fedejoe123/Control_Rotor/images/IMG_20260402_135818938.jpg

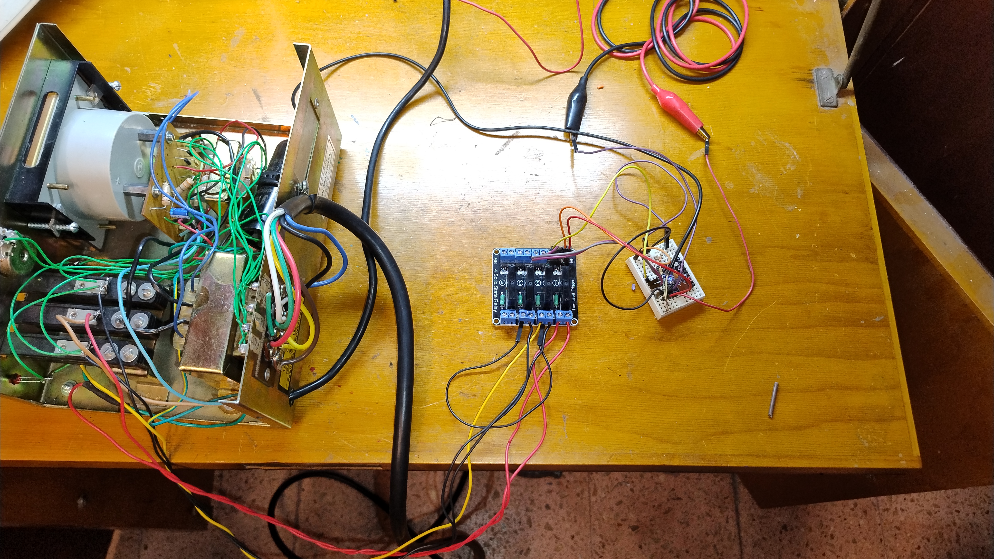
images/IMG_20260402_135818938.jpg
