fedejoe123/Control_Rotor/images/IMG_20260402_141212920.jpg

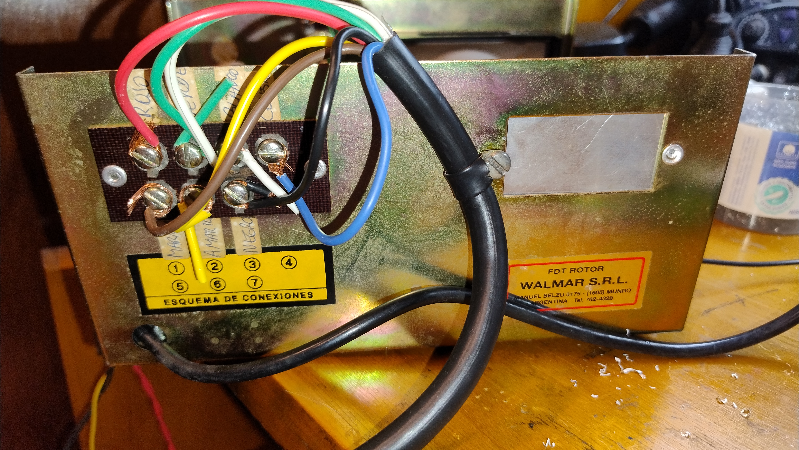
images/IMG_20260402_141212920.jpg
