fedejoe123/Control_Rotor/images/IMG_20260402_151520873.jpg

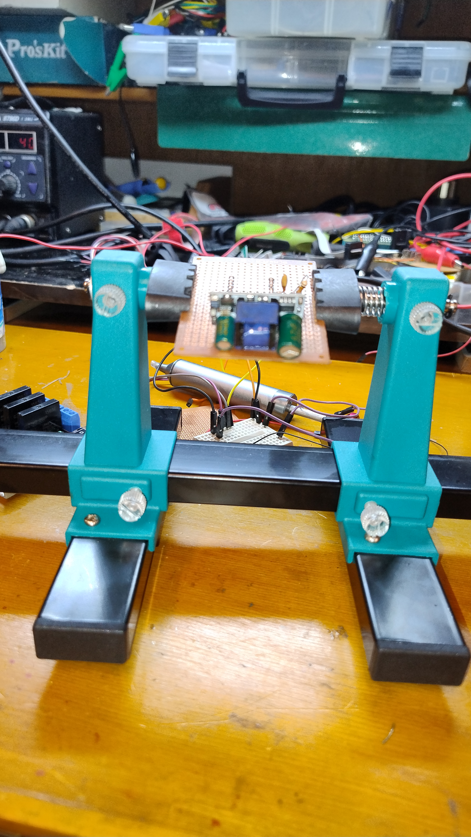
images/IMG_20260402_151520873.jpg
