fedejoe123/Control_Rotor/images/IMG_20260402_173200321.jpg

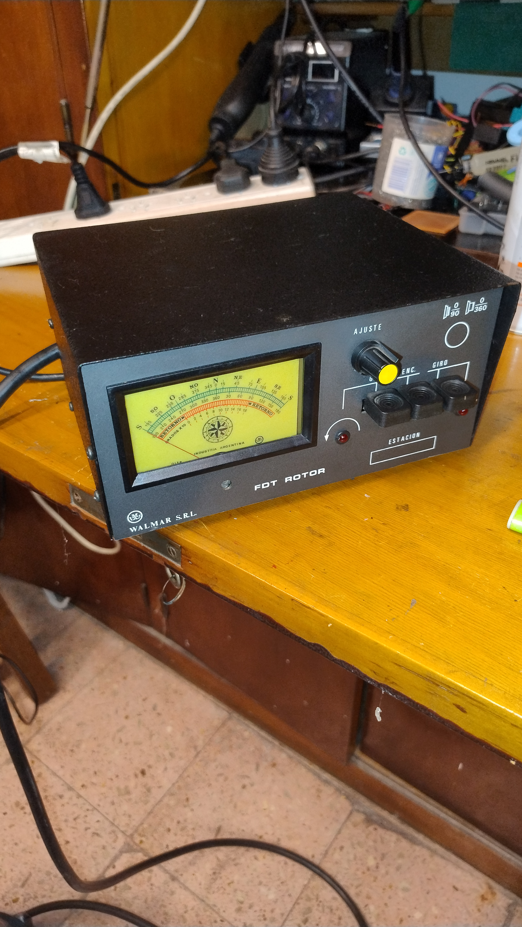
images/IMG_20260402_173200321.jpg
