fedejoe123/Control_Rotor/images/IMG_20260402_173206418.jpg

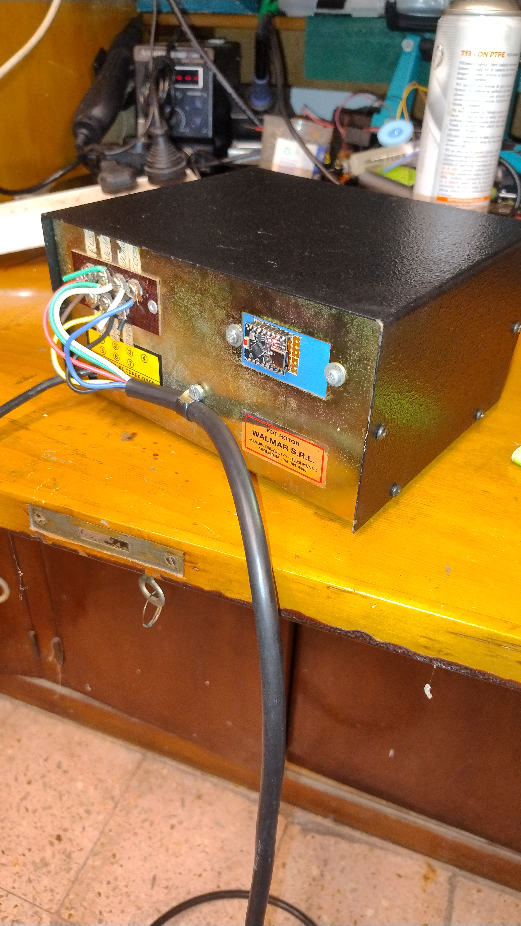
images/IMG_20260402_173206418.jpg
