fedejoe123/Control_Rotor/index_html.h

#ifndef INDEX_HTML_H
#define INDEX_HTML_H

#include <Arduino.h>

#define INDEX_HTML_LEN 20188

const uint8_t INDEX_HTML_GZ[] PROGMEM = {
  0x1F, 0x8B, 0x08, 0x08, 0x66, 0xDF, 0xCD, 0x69, 0x00, 0x03, 0x69, 0x6E, 0x64, 0x65, 0x78, 0x5F,
  0x70, 0x72, 0x65, 0x76, 0x69, 0x65, 0x77, 0x5F, 0x6D, 0x6F, 0x64, 0x2E, 0x68, 0x74, 0x6D, 0x6C,
  0x00, 0xD4, 0x3D, 0xDB, 0x72, 0xDB, 0x48, 0x76, 0xEF, 0xFE, 0x0A, 0x0C, 0x5D, 0xB3, 0xB6, 0xC6,
  0x82, 0x0C, 0x82, 0x17, 0x51, 0x94, 0xA5, 0x2C, 0x45, 0xD1, 0x36, 0x37, 0x22, 0xA9, 0x91, 0xE8,
  0x91, 0xA5, 0x54, 0x1E, 0x40, 0xA0, 0x49, 0xC2, 0x02, 0x01, 0x06, 0x00, 0x49, 0x49, 0x53, 0x4E,
  0x4D, 0x5E, 0xF2, 0x03, 0xD9, 0x4A, 0xE5, 0x75, 0xDF, 0xF3, 0x90, 0xAA, 0x54, 0xE5, 0x21, 0x8F,
  0x99, 0x3F, 0x99, 0x2F, 0xC9, 0xE9, 0x1B, 0xD0, 0x00, 0x1A, 0xE0, 0xC5, 0xF6, 0x6C, 0x32, 0xB3,
  0x1A, 0x09, 0x8D, 0x46, 0x9F, 0xD3, 0xE7, 0xDE, 0xA7, 0x4F, 0xF7, 0xBE, 0xF9, 0xEE, 0x7C, 0xD0,
  0x1E, 0xDE, 0x5E, 0x76, 0x94, 0x69, 0x38, 0x73, 0x4E, 0x9F, 0xBD, 0xC1, 0xBF, 0x14, 0xC7, 0x70,
  0x27, 0x27, 0x25, 0x14, 0x94, 0x70, 0x03, 0x32, 0x2C, 0xF8, 0x35, 0x43, 0xA1, 0xA1, 0x98, 0x53,
  0xC3, 0x0F, 0x50, 0x78, 0x52, 0xFA, 0x30, 0x7C, 0xAB, 0x36, 0x4A, 0xBC, 0xD9, 0x35, 0x66, 0xE8,
  0xA4, 0xB4, 0xB4, 0xD1, 0x6A, 0xEE, 0xF9, 0x61, 0x49, 0x31, 0x3D, 0x37, 0x44, 0x2E, 0x74, 0x5B,
  0xD9, 0x56, 0x38, 0x3D, 0xB1, 0xD0, 0xD2, 0x36, 0x91, 0x4A, 0x1E, 0xF6, 0x15, 0xDB, 0xB5, 0x43,
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
  0x7A, 0xE8, 0x3D, 0x56, 0xCB, 0x5D, 0x80, 0x03, 0x30, 0x75, 0x80, 0x55, 0xC5, 0xB0, 0x01, 0x5E,
  0x31, 0xAC, 0xB7, 0xE6, 0xA6, 0xB0, 0x1E, 0xD9, 0xB8, 0xDA, 0x05, 0x9D, 0xC7, 0x04, 0x78, 0x03,
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
};

#endif // INDEX_HTML_H
