fedejoe123/Control_Rotor/(commit log)

2026-04-02 Revise README for ESP32-C3 Rotor Control Project
    Updated the README to provide detailed information about the ESP32-C3 rotor control project, including features, hardware requirements, installation steps, usage instructions, and API documentation.
2026-04-02 Rename firmware file to rotor_controller.ino
2026-04-07 Revise ESP32-C3 wiring details in README
    Updated wiring diagram for ESP32-C3 and rotor console.
