fedejoe123/Control_Rotor/images/IMG_20260402_135759120.jpg

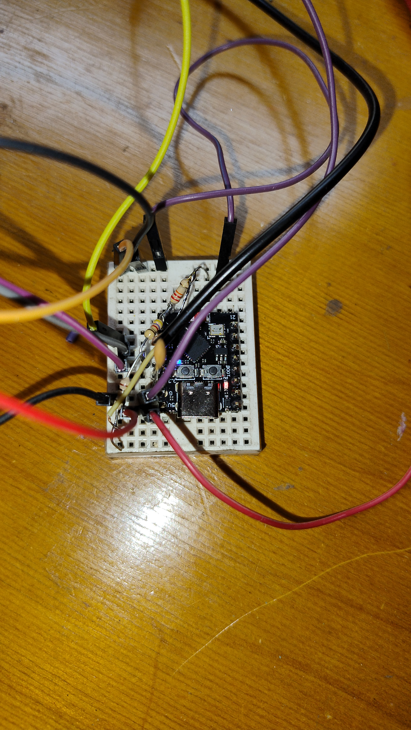
images/IMG_20260402_135759120.jpg
