fedejoe123/Control_Rotor/images/IMG_20260402_135806746.jpg

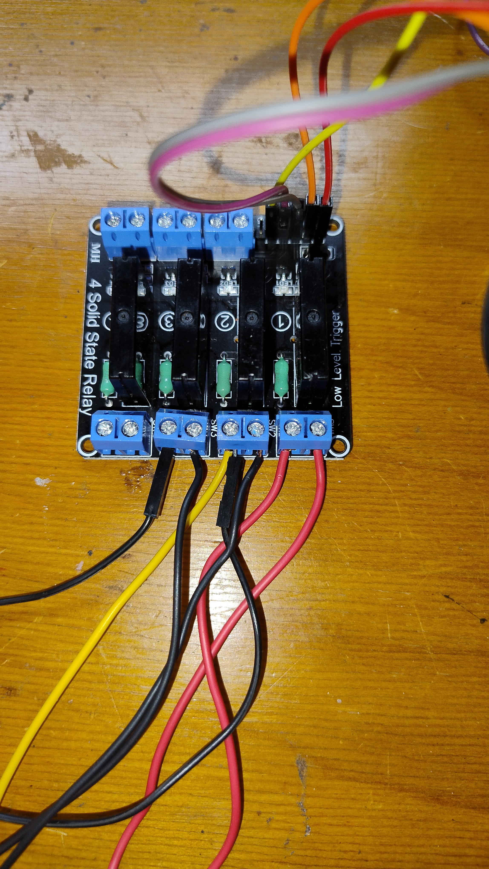
images/IMG_20260402_135806746.jpg
