fedejoe123/Control_Rotor/images/IMG_20260402_135811743.jpg

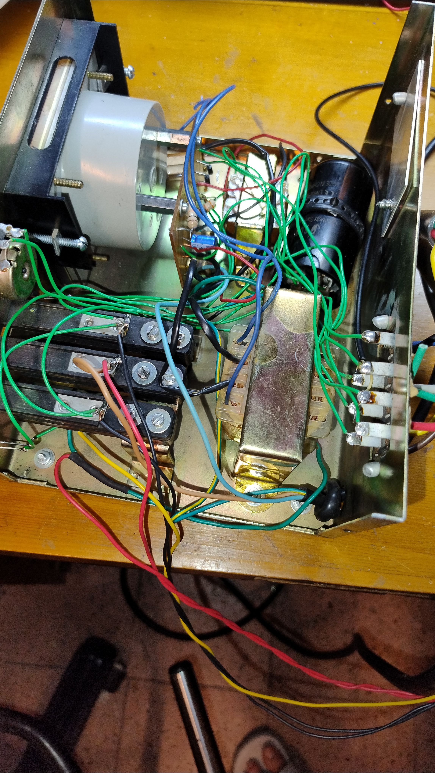
images/IMG_20260402_135811743.jpg
