fedejoe123/Control_Rotor/images/IMG_20260402_140802652.jpg

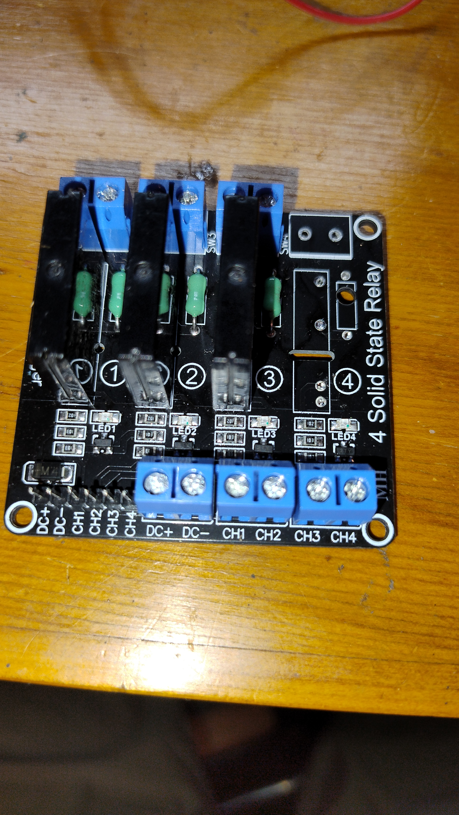
images/IMG_20260402_140802652.jpg
