fedejoe123/Control_Rotor/images/IMG_20260402_141206421.jpg

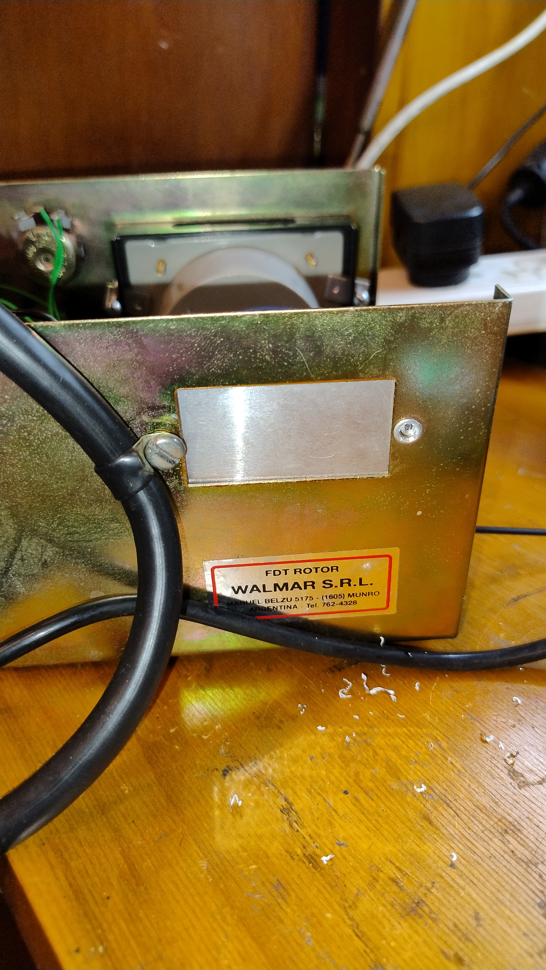
images/IMG_20260402_141206421.jpg
