fedejoe123/Control_Rotor/images/IMG_20260402_145155088.jpg

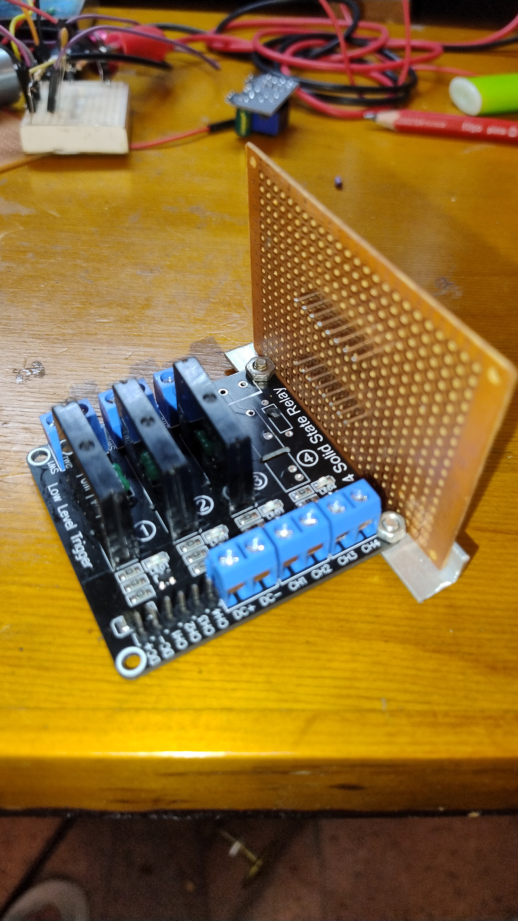
images/IMG_20260402_145155088.jpg
