fedejoe123/Control_Rotor/images/IMG_20260402_145200008.jpg

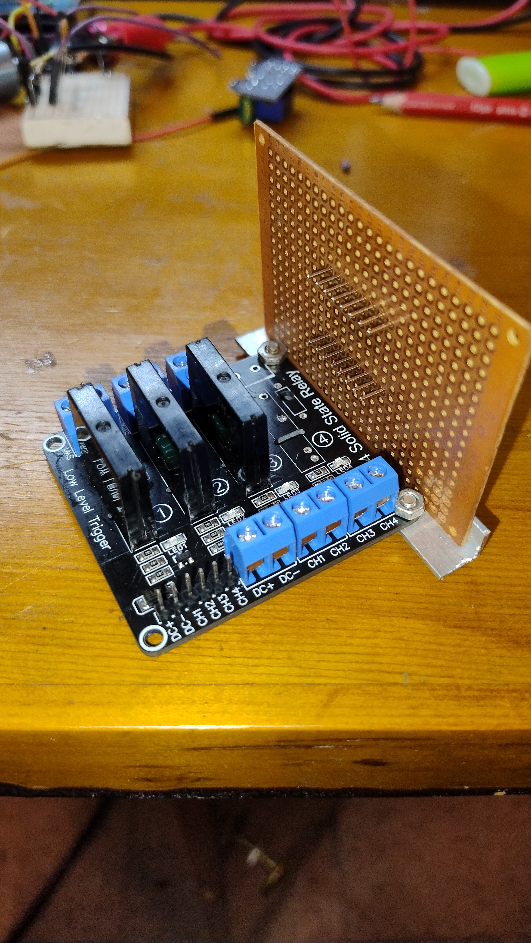
images/IMG_20260402_145200008.jpg
