fedejoe123/Control_Rotor/images/IMG_20260402_145206341.jpg

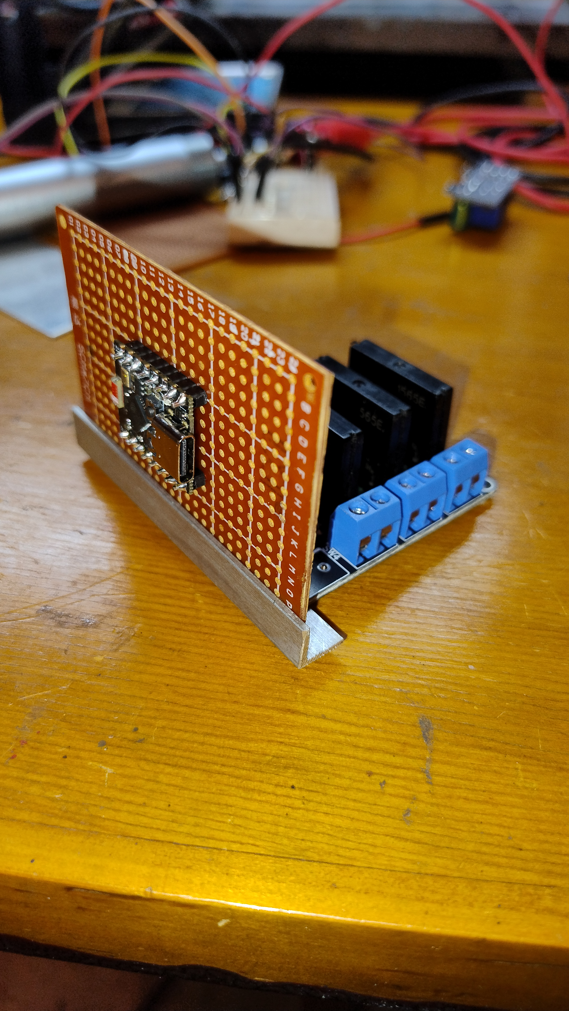
images/IMG_20260402_145206341.jpg
