fedejoe123/Control_Rotor/images/IMG_20260402_145210537.jpg

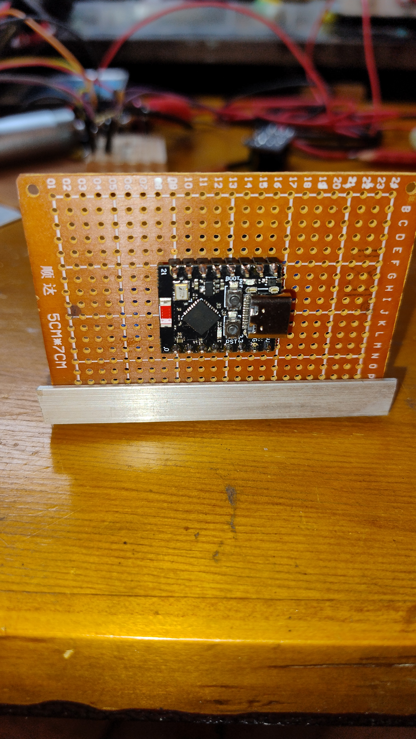
images/IMG_20260402_145210537.jpg
