fedejoe123/Control_Rotor/images/IMG_20260402_145641962.jpg

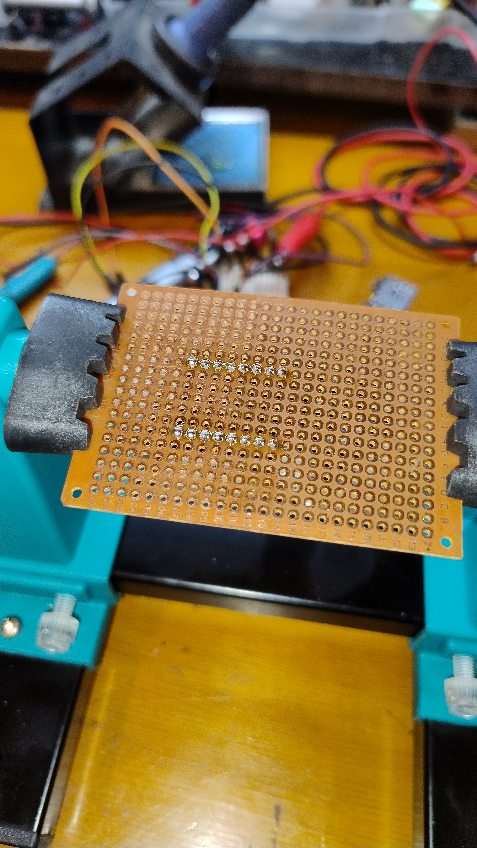
images/IMG_20260402_145641962.jpg
