fedejoe123/Control_Rotor/images/IMG_20260402_145646831.jpg

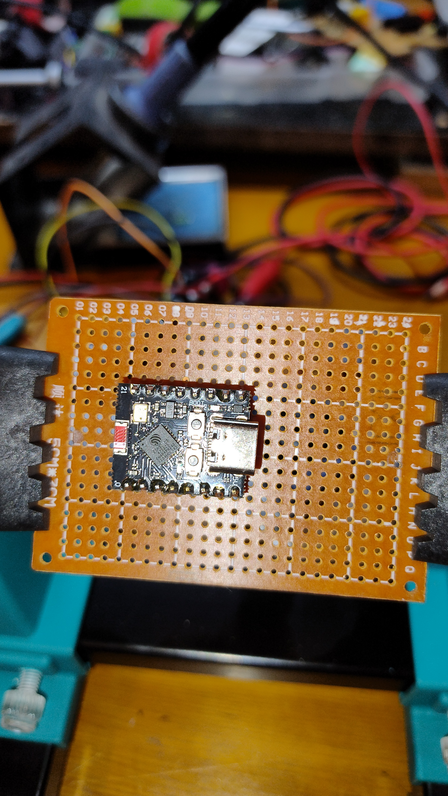
images/IMG_20260402_145646831.jpg
