fedejoe123/Control_Rotor/images/IMG_20260402_151517481.jpg

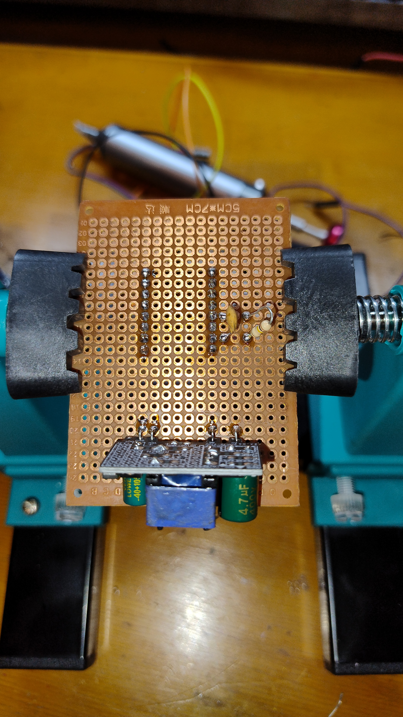
images/IMG_20260402_151517481.jpg
