fedejoe123/Control_Rotor/images/IMG_20260402_155451399.jpg

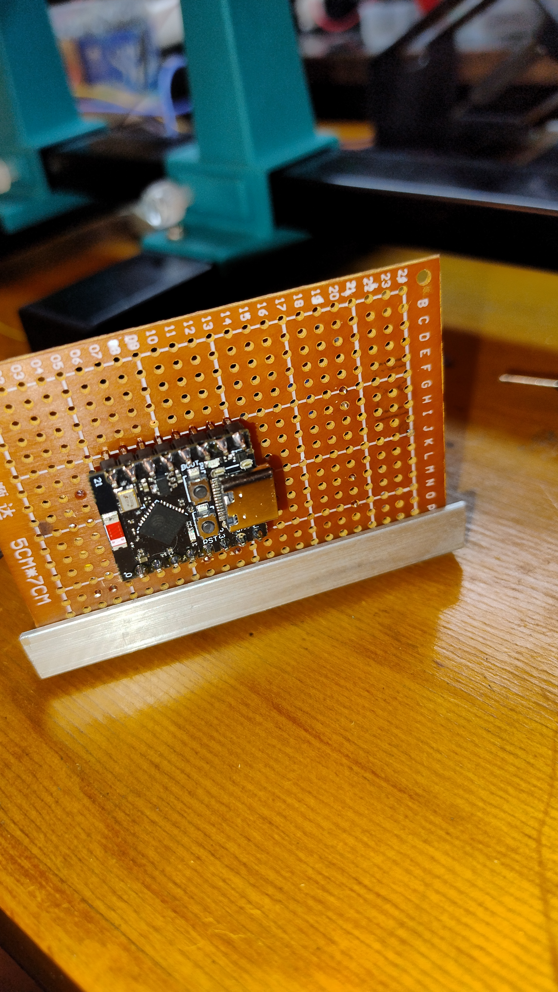
images/IMG_20260402_155451399.jpg
