fedejoe123/Control_Rotor/images/IMG_20260402_162926100.jpg

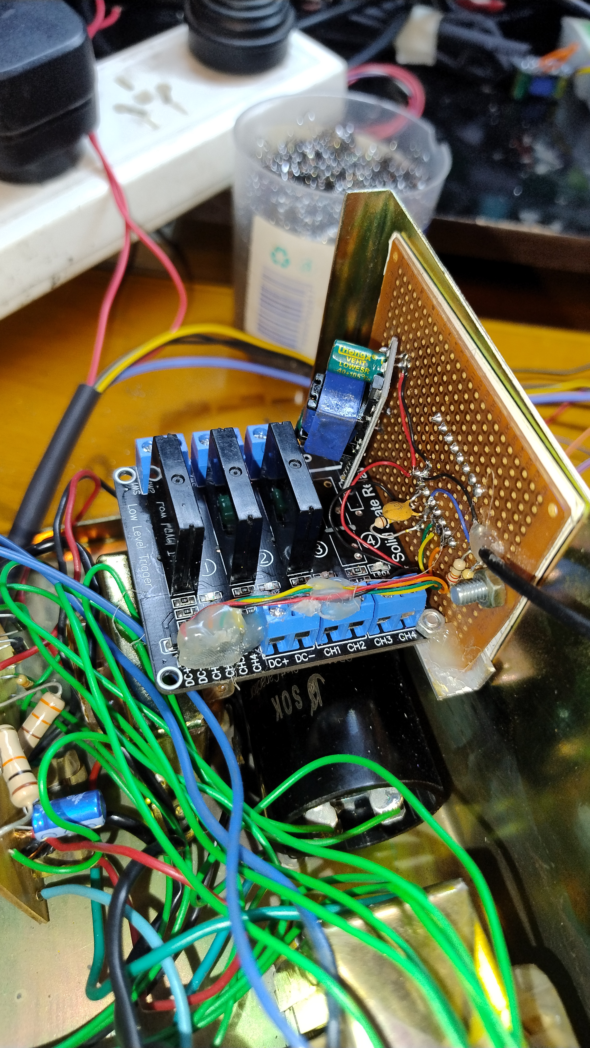
images/IMG_20260402_162926100.jpg
