fedejoe123/Control_Rotor/images/IMG_20260402_162933220.jpg

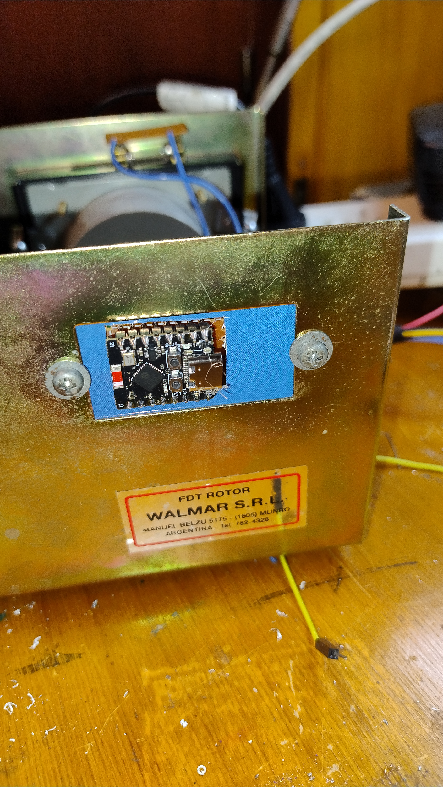
images/IMG_20260402_162933220.jpg
