fedejoe123/Control_Rotor/images/IMG_20260402_172451835.jpg

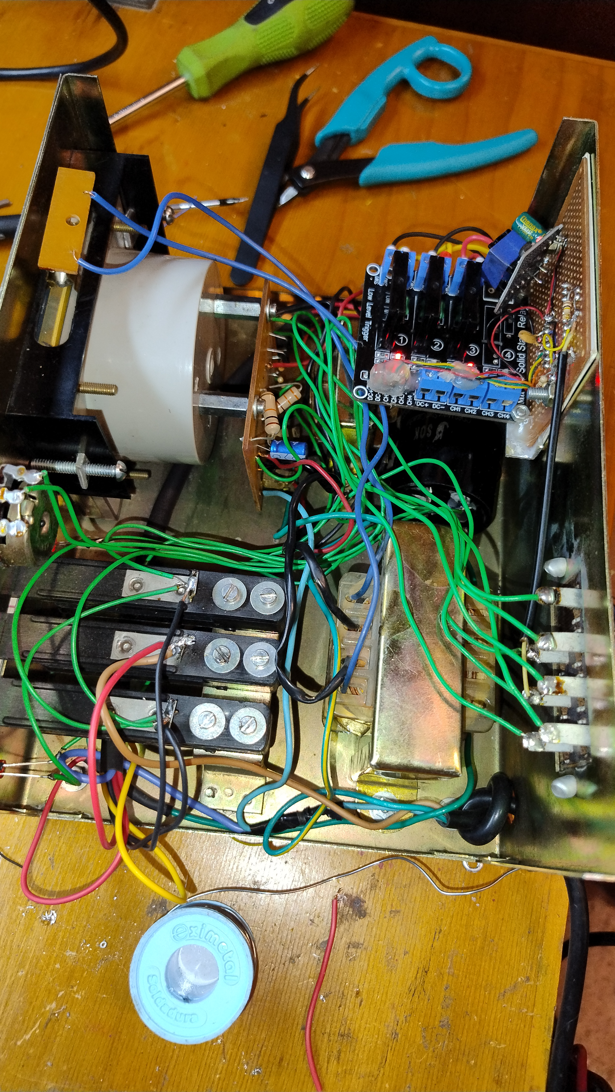
images/IMG_20260402_172451835.jpg
