fedejoe123/Control_Rotor/images/IMG_20260402_172459070.jpg

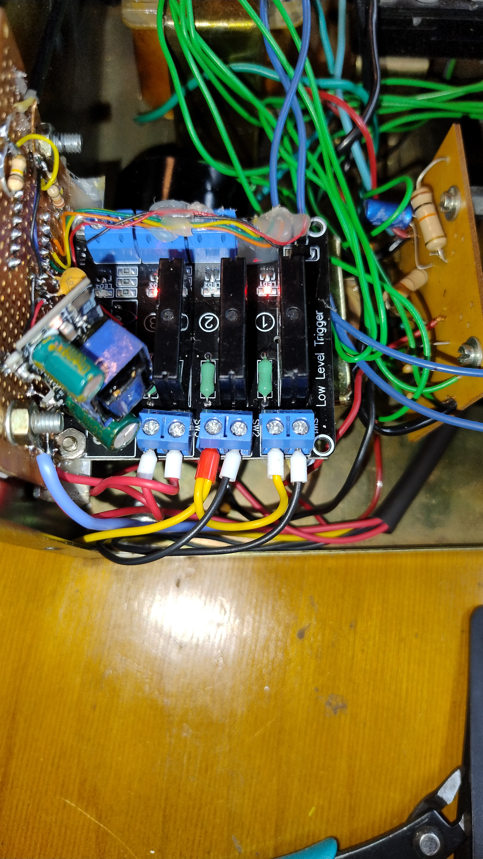
images/IMG_20260402_172459070.jpg
