fedejoe123/Control_Rotor/images/IMG_20260402_172504201.jpg

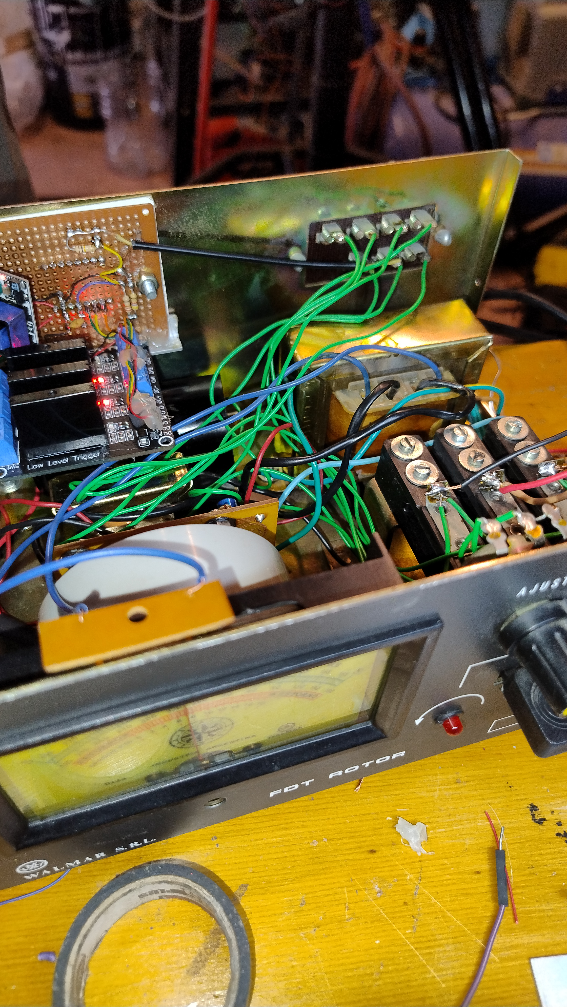
images/IMG_20260402_172504201.jpg
