fedejoe123/Control_Rotor/images/IMG_20260402_172506924.jpg

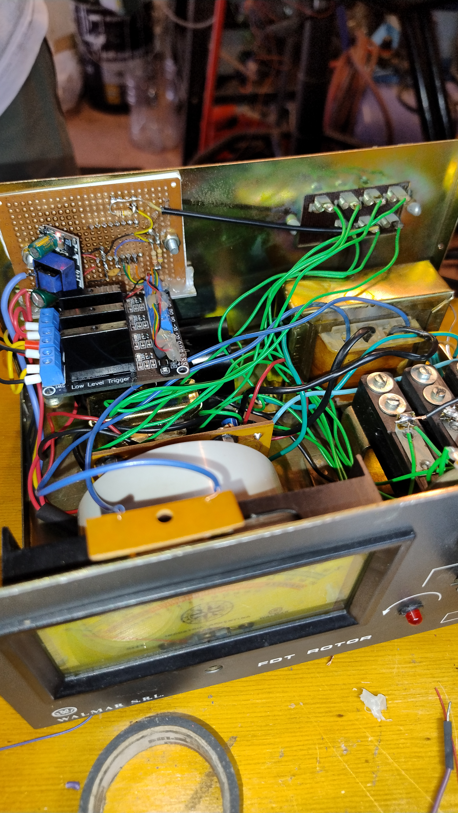
images/IMG_20260402_172506924.jpg
