fedejoe123/Control_Rotor/images/IMG_20260402_155445802.jpg

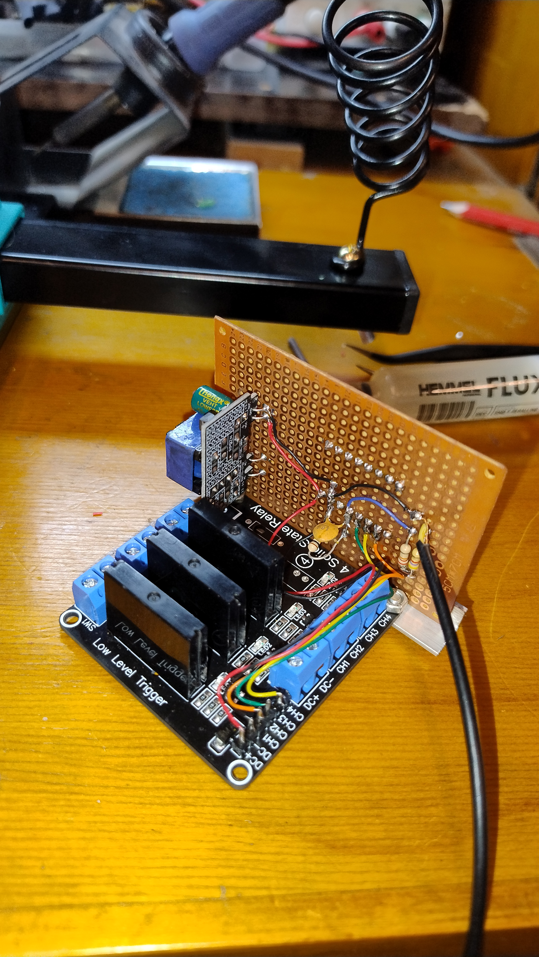
[picture p2: images/IMG_20260402_155445802.jpg]
images/IMG_20260402_155445802.jpg
